cvaldess/se050-breakout/se050_breakout.kicad_pcb

## KiCad design se050_breakout.kicad_pcb (2026-08-26)

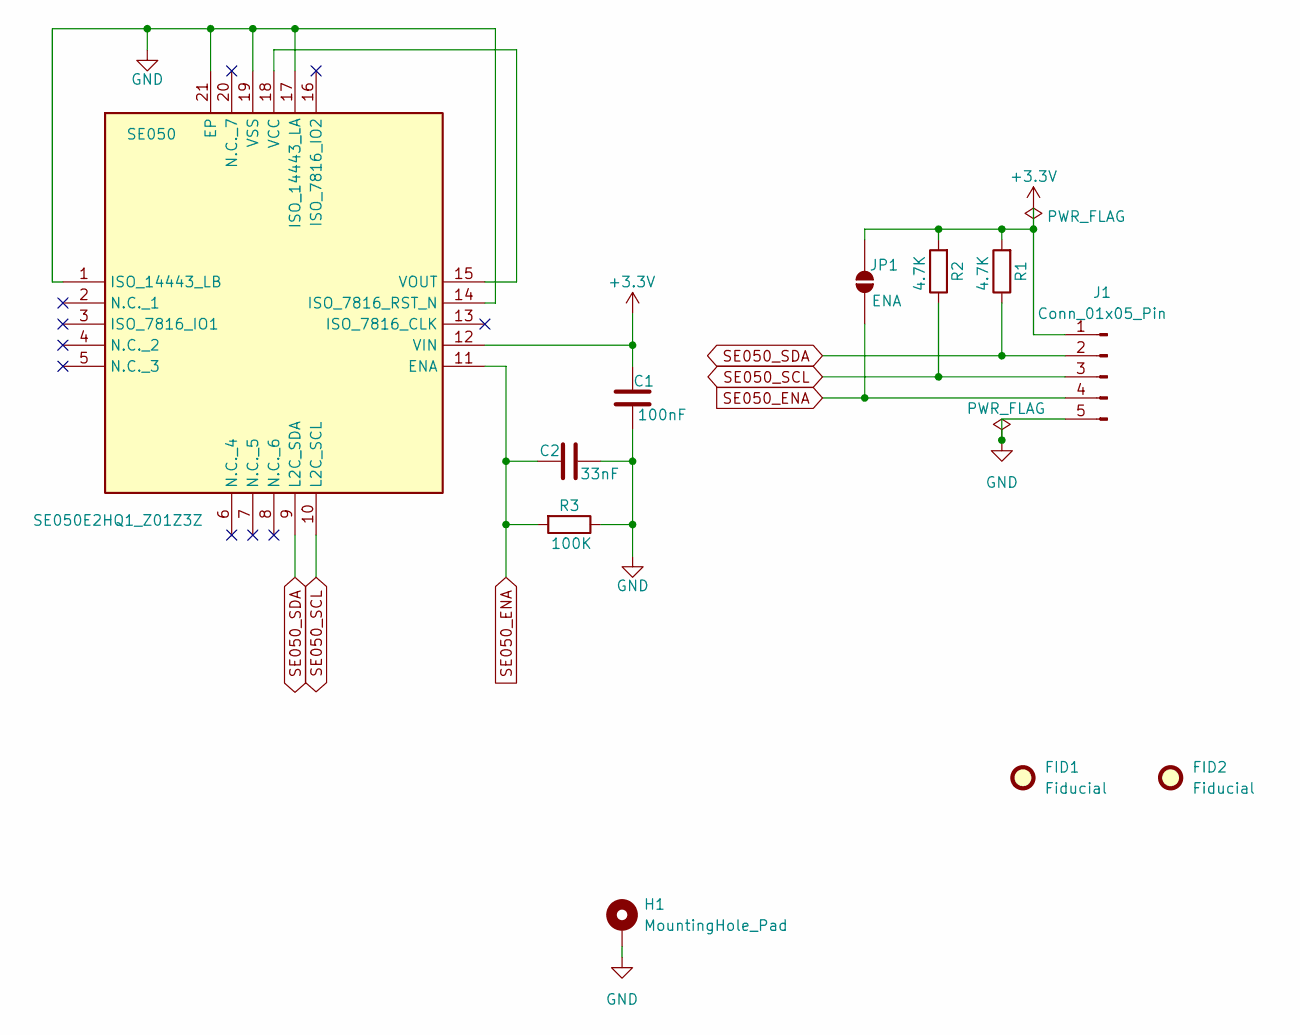
[picture p2: schematic se050_breakout.kicad_sch]

Parts:
C1: 100nF; C_0402_1005Metric; LCSC Part C1525
C2: 33nF; C_0402_1005Metric; LCSC Part C106862
FID1, FID2: Fiducial; Fiducial_1mm_Mask2mm
H1: MountingHole_Pad; MountingHole_2.2mm_M2_DIN965_Pad
J1: Conn_01x05_Pin; PinHeader_1x05_P2.00mm_Vertical
JP1: ENA; SolderJumper-2_P1.3mm_Open_RoundedPad1.0x1.5mm
R1, R2: 4.7K; R_0402_1005Metric; LCSC Part C105871
R3: 100K; R_0402_1005Metric; LCSC Part C60491
SE050: SE050E2HQ1_Z01Z3Z; QFN40P300X300X33-21N-D; MANUFACTURER_PART_NUMBER SE050E2HQ1/Z01Z3Z; Mouser Part Number 771-SE050E2HQ1Z01Z3Z

Connections:
+3.3V: C1.1, J1.1, JP1.2 (B), R1.2, R2.2, SE050.12 (VIN)
GND: C1.2, C2.2, H1.1 (1_1), J1.5, R3.1, SE050.1 (ISO_14443_LB), SE050.14 (ISO_7816_RST_N), SE050.17 (ISO_14443_LA), SE050.19 (VSS), SE050.21 (EP)
unnamed: SE050.15 (VOUT), SE050.18 (VCC)
SE050_ENA: C2.1, J1.4, JP1.1 (A), R3.2, SE050.11 (ENA)
SE050_SCL: J1.3, R2.1, SE050.10 (L2C_SCL)
SE050_SDA: J1.2, R1.1, SE050.9 (L2C_SDA)

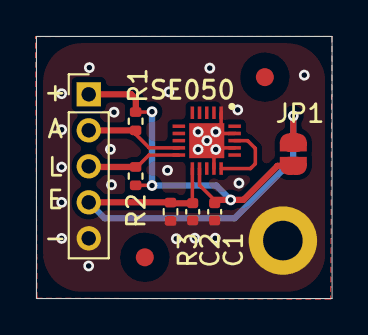
[picture p3: board se050_breakout.kicad_pcb from above]

Board: 2 copper layers, 16.4 x 14.6 mm, 11 parts (0 on the bottom side), 6 nets.
