cvaldess/se050-breakout/(commit log)

2026-08-12 Add KiCad project, self-contained library and fabrication output
    Breakout board for the NXP EdgeLock SE050E2HQ1 secure element: 16.33 x
    12.72 mm, two layers, I2C brought out to a 1x5 header on a 2 mm pitch.
    The SE050 symbol, footprint and STEP model are committed alongside the
    board and referenced through ${KIPRJMOD}, so the project opens on any
    machine without installing external libraries.
    gerber/ holds the full fabrication package unzipped: both copper layers,
    both masks, both silkscreens, the outline, paste layers for both sides
    (for stencil ordering) and Excellon drill files with plated and
    non-plated holes separated, plus drill maps. Copper pours are filled in
    the exported gerbers.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
2026-08-12 Add JP1 solder jumper to tie ENA high without a spare GPIO
    The SE050 comes up in deep power-down because R3 holds ENA low, so a
    host that never drives that pin finds nothing at 0x48 - and firmware
    commonly does ignore it, the Meshtastic SE050 driver among others.
    JP1 is a bottom-side solder jumper between ENA and 3V3, shipped open:
    bridge it and the part is permanently enabled, leave it open and drive
    ENA from the header as before. Closing it costs only deep power-down
    (<5 uA), the one mode that pad controls; software power-down with state
    retention still works either way.
    Gerbers regenerated from the updated board. The jumper lands on B.Cu,
    B.Mask and B.Silkscreen but deliberately not on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
2026-08-12 Tie SE050 RST_N to ground instead of the 3V3 rail
    Pin 14 is referenced to VCC, and VCC reaches the die from VOUT through
    an internal switch that opens in deep power-down. Since R3 holds ENA low
    by default, deep power-down is this board's resting state: VCC sits at
    0 V while VIN stays at 3.3 V, leaving a pin tied to the rail above its
    own reference.
    The data sheet allows either VCC or VSS for this pad, and VSS is the one
    that holds in every state. It cannot hold the part in reset either,
    because RST_N is only active when the ISO7816 interface is enabled,
    which is not the case on generic E2 parts.
    Gerbers regenerated. DRC: 0 violations, 0 unconnected, 0 schematic
    parity issues.
2026-08-12 Drop the bottom silkscreen and regenerate fabrication files
    The bottom legend held nothing but JP1's outline and label, so clearing
    it keeps the board on the cheaper single-sided silkscreen option. The
    layer is now empty and is no longer exported at all, rather than shipping
    an empty gerber that a fab would still count as a bottom legend.
    The trade-off is that JP1 is unlabelled on the finished board, so the
    README now says where to find it.
    gerber/ regenerated from the current board: copper, masks, top
    silkscreen, outline, both paste layers and the Excellon drills. Copper
    pours are filled.
    DRC is clean except for one warning: JP1 no longer matches the stock
    Jumper library footprint, which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
2026-08-26 Add assembly fiducials and refresh the fabrication output
    The board grows to 16.42 x 14.56 mm to make room for two 1 mm fiducials placed
    diagonally, each with a 3 mm keepout drawn as a rule area on the top copper so
    the ground pour backs away and leaves an assembly camera a clean target. The
    circuit is unchanged; this only makes the board usable for machine assembly.
    Correct the LCSC part number on R1 and R2. Both carried C60491, which is a
    100k resistor, so a machine-assembled board would have shipped with 100k
    pull-ups on the I2C bus instead of 4k7 and the SE050 would not have answered.
    Regenerate gerber/. It still held the August layout and no longer matched the
    board, so anyone orderin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
2026-08-26 Correct the side JP1 is on
    JP1 sits on the top copper and its reference is on the top silkscreen, but the
    README still described it as a bottom-side jumper in the ENA section and in the
    bill of materials. Someone following it would turn the board over looking for a
    jumper that is not there.
2026-08-27 Add 3D PCB layout image to README
    Added a 3D PCB layout image to the README.
2026-10-26 Update README with purchase options for assembled boards
    Added links for purchasing assembled boards and additional information.
